mf21/DOMOVOY-Fish-Feeder/README.md

# DOMOVOY-Fish-Feeder
Smart Fish Feeder is a part of DOMOVOY home automation project

https://www.mf21.ru - russian site,

https://www.diyorbuy.tech - english site
