mf21/DOMOVOY-Fish-Feeder/docs/rus/DОМОВОЙ. Монтаж электронной платы.pdf

# ЦЕНТР ТЕХНИЧЕСКИХ РАЗРАБОТОК

## Монтаж электронной платы

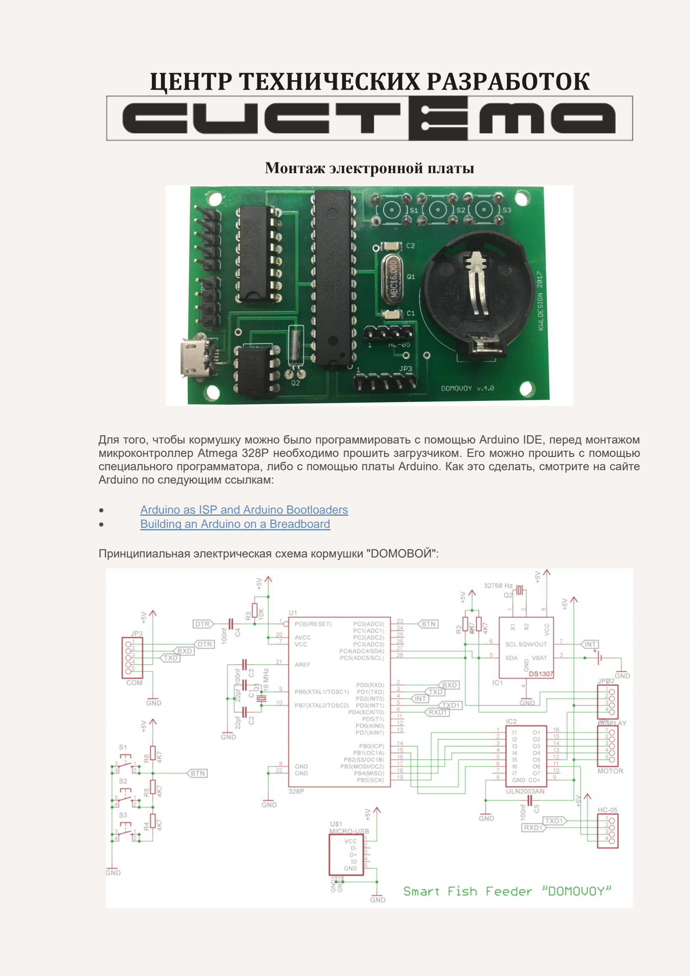
[picture p1: page 1]

Для того, чтобы кормушку можно было программировать с помощью Arduino IDE, перед монтажом микроконтроллер Atmega 328P необходимо прошить загрузчиком. Его можно прошить с помощью специального программатора, либо с помощью платы Arduino. Как это сделать, смотрите на сайте Arduino по следующим ссылкам:

- Arduino as ISP and Arduino Bootloaders (https://www.arduino.cc/en/Tutorial/ArduinoISP)
- Building an Arduino on a Breadboard (https://www.arduino.cc/en/Main/Standalone)

Принципиальная электрическая схема кормушки "DОМОВОЙ":

Детали, необходимые для сборки платы:

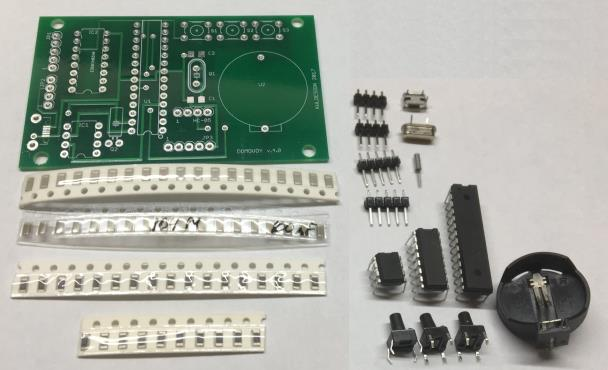
[picture p2: figure]
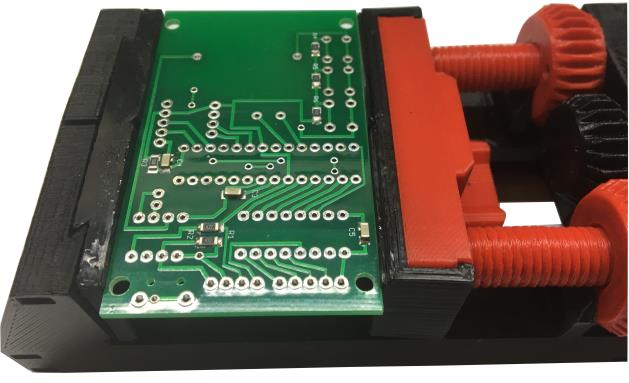
[picture p3: figure]

Подготовьте детали для сборки. | Первыми установите smd компоненты.

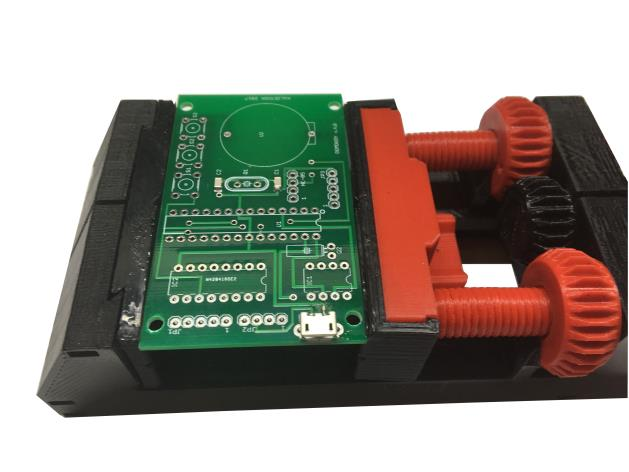
[picture p4: figure]

Установите разъем и конденсаторы на обороте платы.

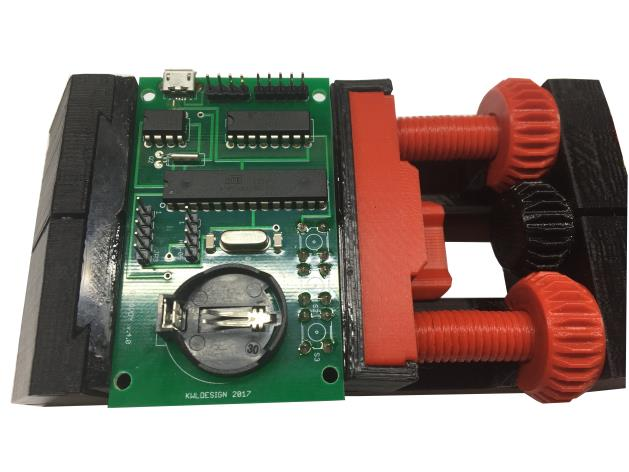
[picture p5: figure]

Установите остальные компоненты.

Наименование | Обозначение на плате | Номинал
Конденсаторы 1206 | C1, C2 | 22 pF
Конденсаторы 1206 | C3, C4, C5 | 100 nF
Резисторы 1206 | R1, R2, R4, R5, R6 | 4K7
Резистор 1206 | R3 | 10 K
Чип RTC | IC1 | DS1307
Драйвер шагового двигателя | IC2 | ULN2003A
Кварцевый резонатор | Q1 | 16 MHz
Кварцевый резонатор | Q2 | 32768 Hz
Микроконтроллер | U1 | Atmega328P-PU
Держатель батареи | U2 | CR2032 Holder
Коннектор | JP1, JP3 | 5 pin header
Коннектор | JP2, HC-05 | 4 pin heade
Кнопки | S1, S2, S3 | Omron Switch
Коннектор | U$1 | Micro-USB

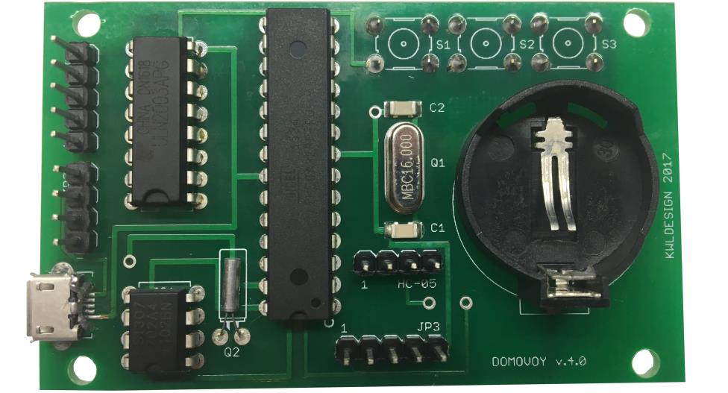
[picture p6: figure]
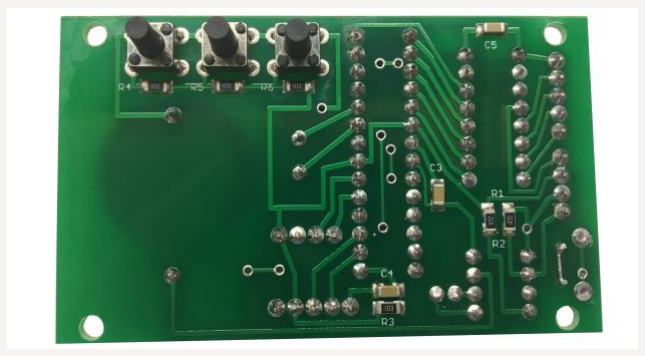
[picture p7: figure]

Вид готовой платы, верхняя сторона. | Вид готовой платы, нижняя сторона.

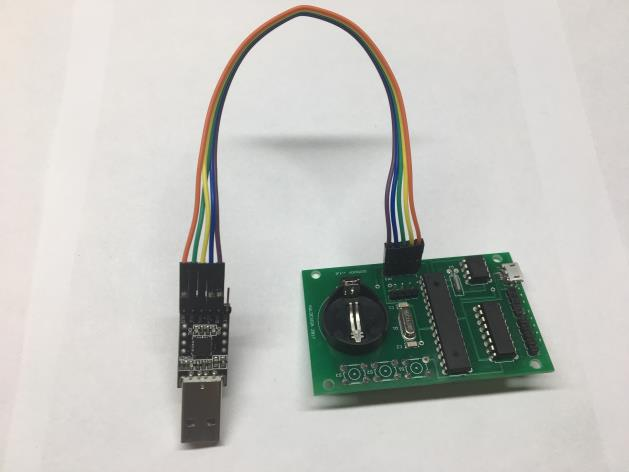
[picture p8: figure]

Используйте программатор USB-UART для прошивки контроллера.

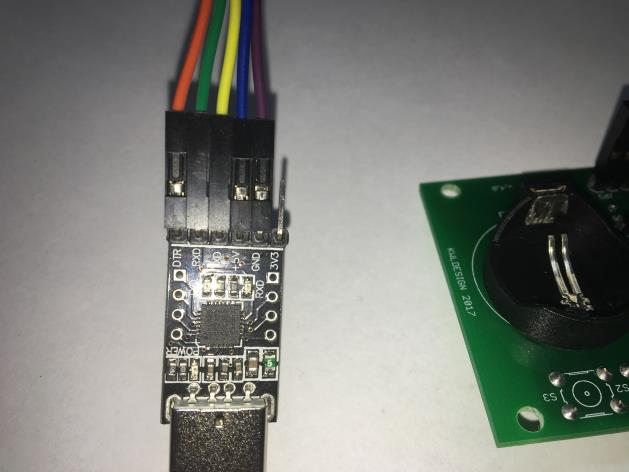
[picture p9: figure]

Схема подключения программатора.
