mf21/DOMOVOY-Fish-Feeder/hardware/hardware.pdf

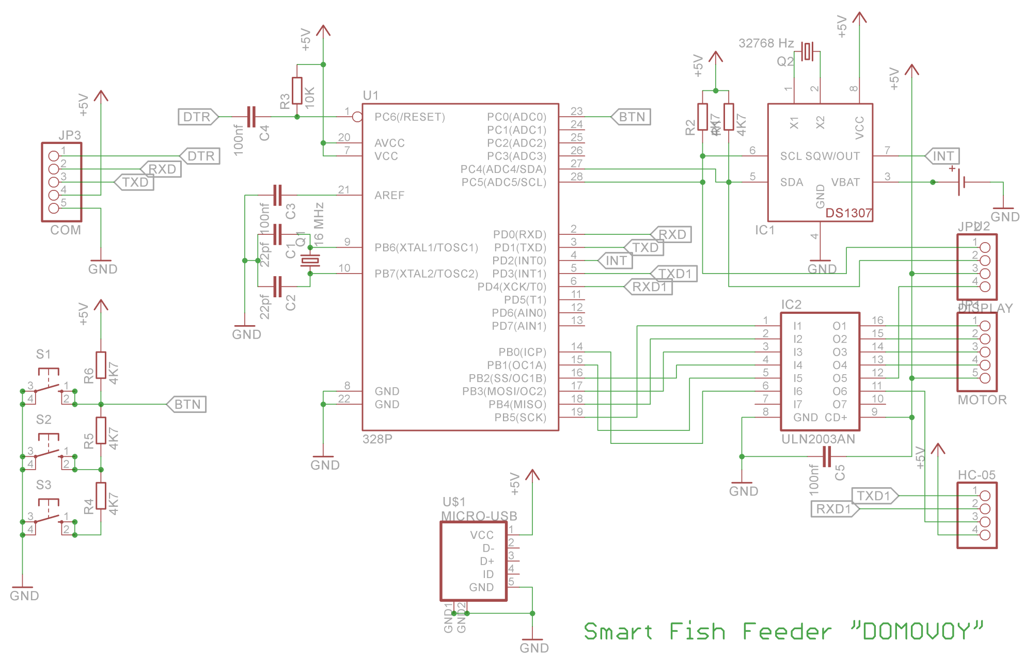
[picture p10: page 1]
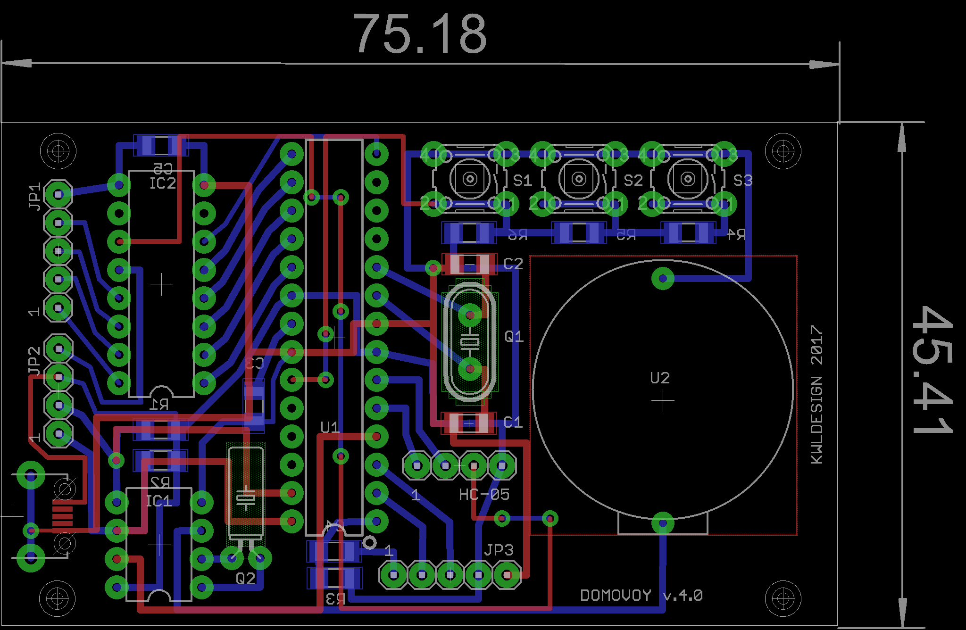
[picture p11: page 2]
