mf21/DOMOVOY-Fish-Feeder/docs/rus/DОМОВОЙ. Примечание к конструктору.pdf

центр технических разработок

### Автоматическая кормушка для аквариумных рыб «DОМОВОЙ»

### Примечание к конструктору

Уважаемый покупатель!

Руководство по сборке кормушки Вы сможете найти на нашем сайте:

https://www.mf21.ru/avtomaticheskaya-kormushka-dlya-ryb

в разделе «Инструкции»
