mf21/DOMOVOY-Fish-Feeder/docs/rus/DОМОВОЙ. Сборка корпуса.pdf

# ЦЕНТР ТЕХНИЧЕСКИХ РАЗРАБОТОК

# Сборка корпуса

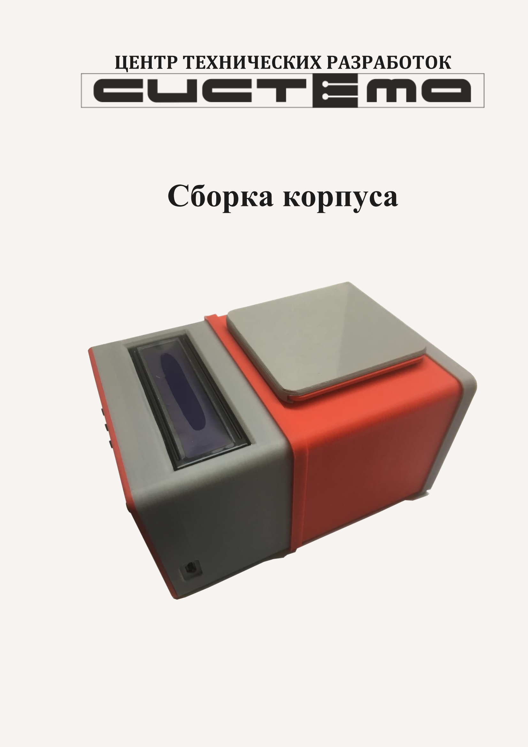
[picture p12: page 1]
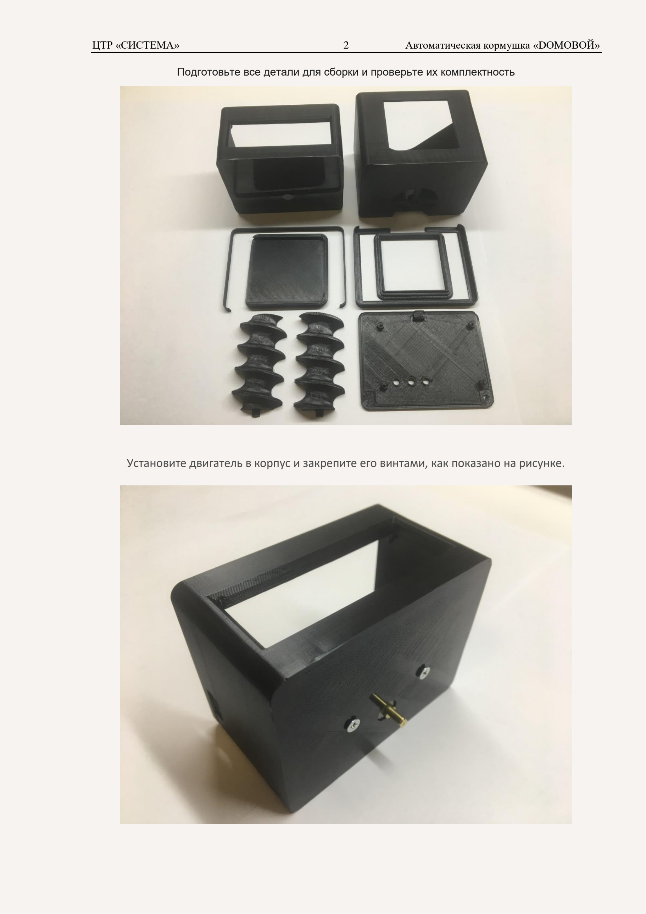
[picture p13: page 2]

ЦТР «СИСТЕМА» | 2 | Автоматическая кормушка «DОМОВОЙ»

Подготовьте все детали для сборки и проверьте их комплектность

Установите двигатель в корпус и закрепите его винтами, как показано на рисунке.

ЦТР «СИСТЕМА» | 3 | Автоматическая кормушка «DОМОВОЙ»

Склейте шнек из двух половинок

Установите шнек внутрь корпуса. Оберните малярным скотчем края половинок корпуса для предотвращения загрязнения поверхностей излишками клея

ЦТР «СИСТЕМА» | 4 | Автоматическая кормушка «DОМОВОЙ»

Аккуратно склейте половинки корпуса.

Оклейте корпус малярным скотчем, как показано на рисунке, для наклейки декоративной рамки.

ЦТР «СИСТЕМА» | 5 | Автоматическая кормушка «DОМОВОЙ»

Приклейте рамку к корпусу кормушки.

Удалите малярный скотч с корпуса кормушки.

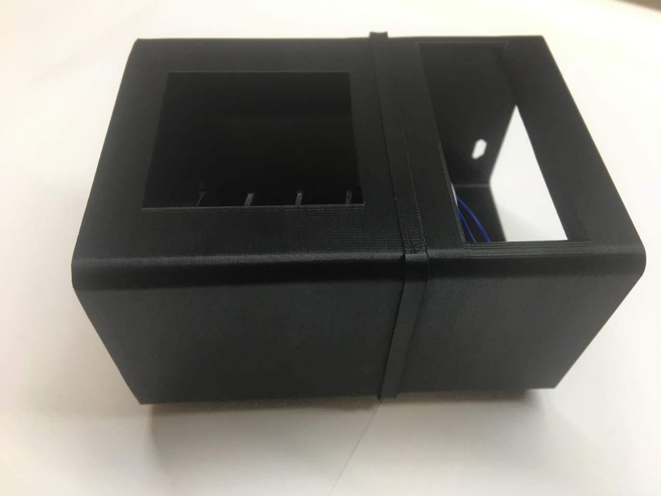
[picture p14: figure]

ЦТР «СИСТЕМА» | 6 | Автоматическая кормушка «DОМОВОЙ»

Аналогичным образом подготовьте переднюю часть корпуса и наклейте вторую декоративную рамку.

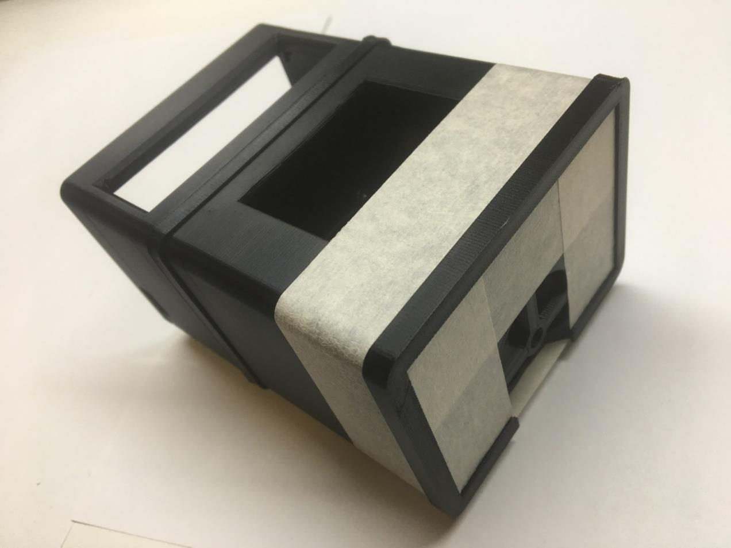
[picture p15: figure]

Удалите скотч после склейки.

ЦТР «СИСТЕМА» | 7 | Автоматическая кормушка «DОМОВОЙ»

Приклейте горловину на верхнюю часть корпуса кормушки.

Установите на горловину крышку, как показано на рисунке.

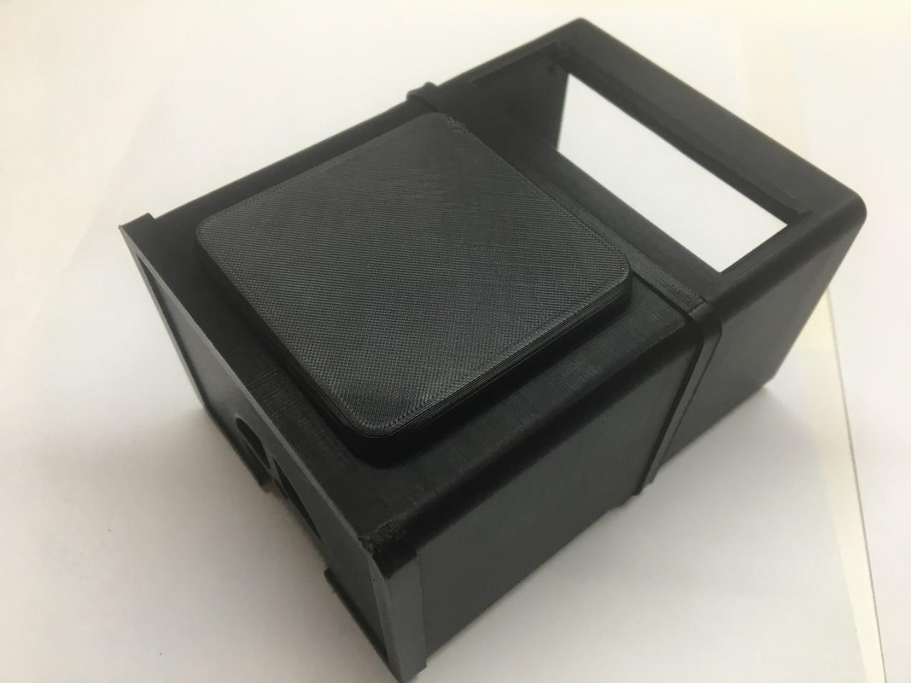
[picture p16: figure]

ЦТР «СИСТЕМА» | 8 | Автоматическая кормушка «DОМОВОЙ»

Отогните штырьки разъема дисплея вертикально вверх, как показано на рисунке.

Установите дисплей внутрь корпуса, зафиксируйте направляющие корпуса в крепежных отверстиях дисплея.

ЦТР «СИСТЕМА» | 9 | Автоматическая кормушка «DОМОВОЙ»

Подготовьте клеевой пистолет. Установите Bluetooth модуль в отведенное место на корпусе кормушки.

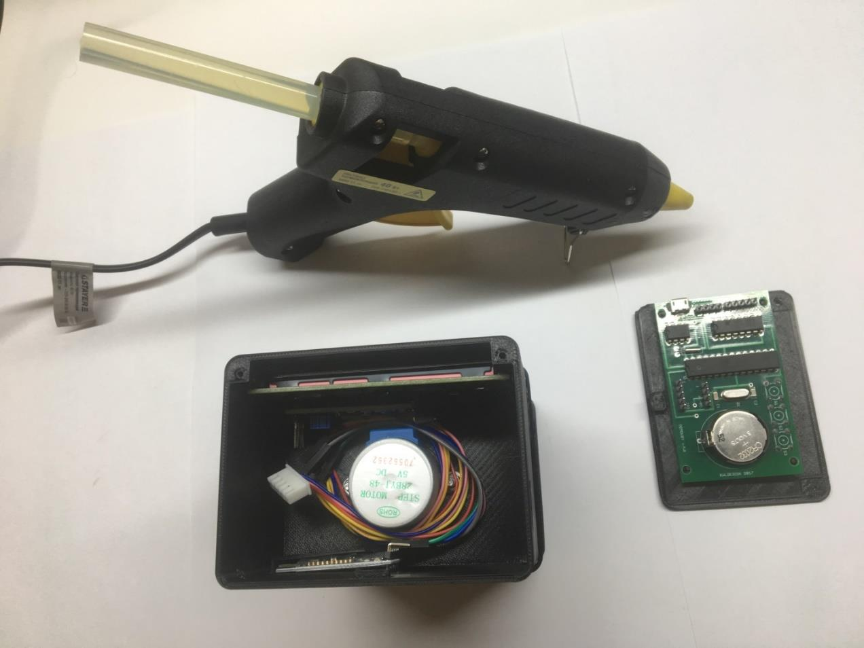
[picture p17: figure]

На заднюю крышку корпуса установите собранную плату.

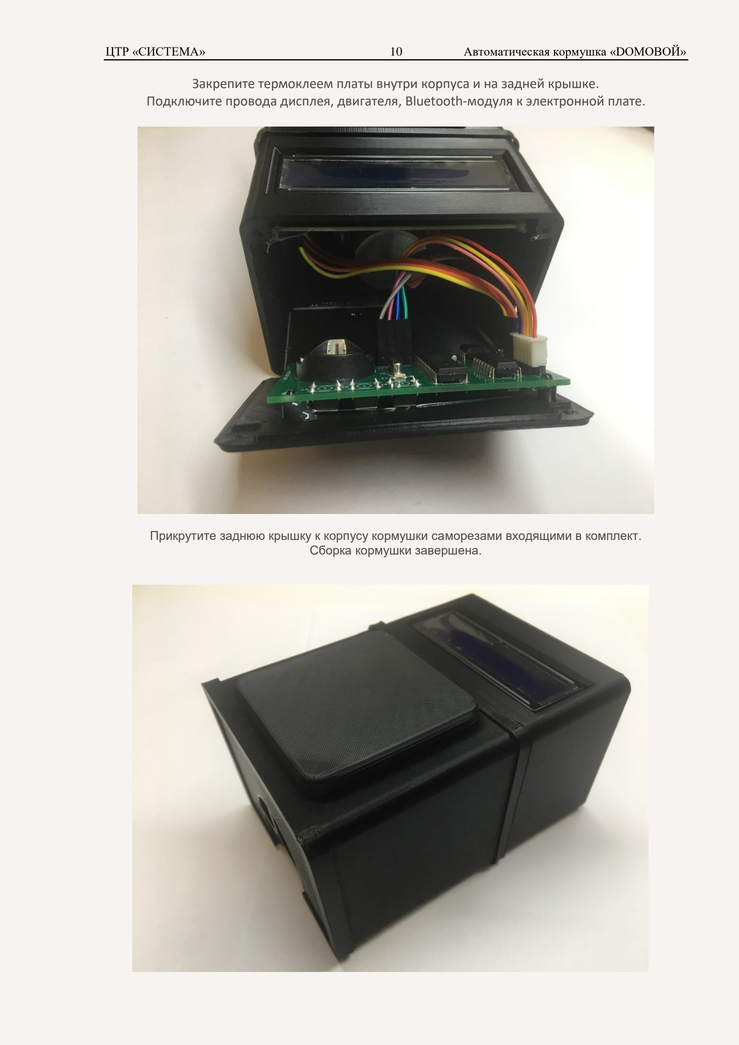
[picture p18: page 10]

ЦТР «СИСТЕМА» | 10 | Автоматическая кормушка «DОМОВОЙ»

Закрепите термоклеем платы внутри корпуса и на задней крышке. Подключите провода дисплея, двигателя, Bluetooth-модуля к электронной плате.

Прикрутите заднюю крышку к корпусу кормушки саморезами входящими в комплект. Сборка кормушки завершена.
