mf21/DOMOVOY-Fish-Feeder/docs/rus/DОМОВОЙ. Руководство по эксплуатации.pdf

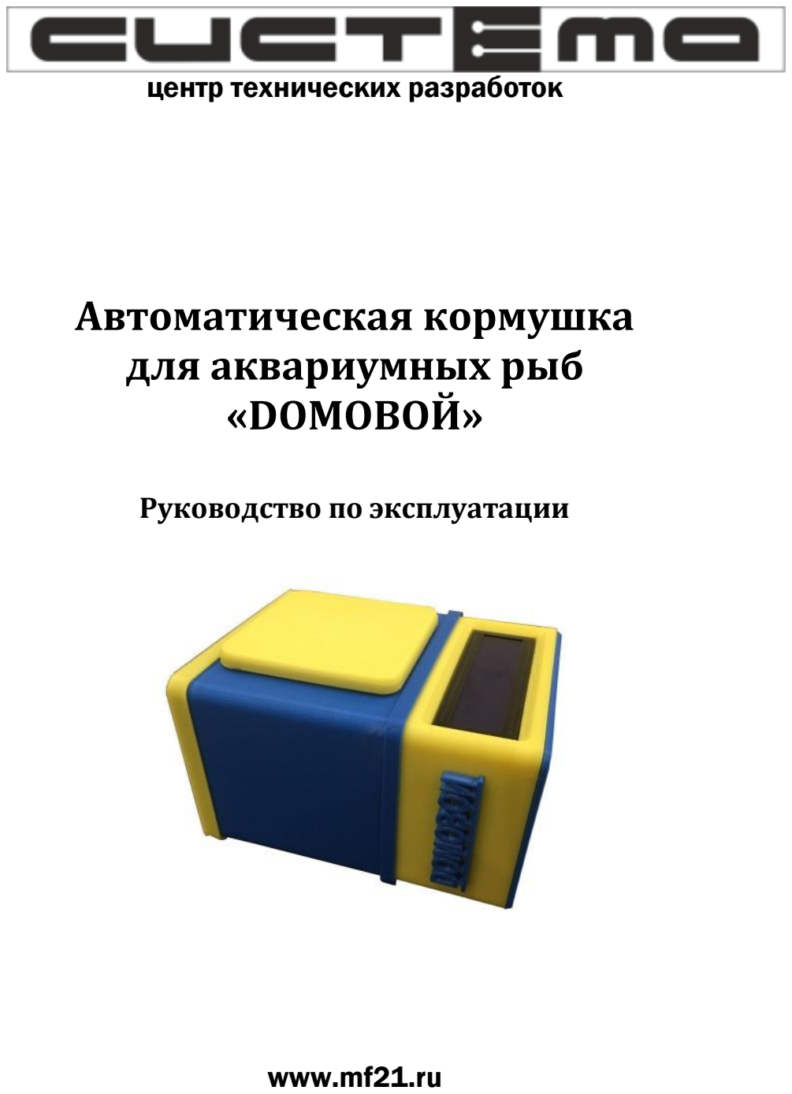
[picture p19: page 1]

центр технических разработок

# Автоматическая кормушка для аквариумных рыб «DОМОВОЙ»

### Руководство по эксплуатации

www.mf21.ru

Введение
Благодарим Вас за выбор нашей автокормушки. Мы постоянно занимаемся совершенствованием наших продуктов и надеемся, что они принесут Вам пользу и оправдают Ваши ожидания.

Комплектация
В коробке Вы найдете:
1. Кормушку DОМОВОЙ.
2. Крышку для отсека с кормом (установлена на кормушку).
3. Кабель питания.
4. Блок питания 5В.

Подготовка к эксплуатации
Подготовьте место установки на Вашем аквариуме. При необходимости проделайте в крышке аквариума необходимое отверстие. Место установки должно иметь достаточную плоскость для установки кормушки. Не допускается свисание над водой части корпуса кормушки более 1 см. Не допускается установка кормушки на искривленные поверхности.

Поместите кормушку на аквариум и убедитесь в ее стабильном положении. Подключите кабель питания сначала к кормушке, затем к блоку питания. Включите блок питания в розетку. Экран кормушки должен засветиться синим светом и на нем должна появиться надпись «Я DОМОВОЙ!» и табло времени.

Загрузка корма
Сдвиньте крышку отсека с кормом в сторону. Засыпьте корм в кормушку. Сдвиньте крышку обратно до упора.

Элементы управления
Кормушка имеет три кнопки расположенные вертикально. Верхняя кнопка отвечает за выбор режимов программирования. Средняя кнопка изменяет часы при установке времени. Нижняя кнопка устанавливает минуты. При последовательном нажатии на одну и ту же кнопку выдерживайте паузу величиной в 1 секунду.

Установка часов
Для установки времени, нажмите два раза на верхнюю кнопку. Первое нажатие включит дисплей и отобразит начальный экран системы, второе – переведет кормушку в режим установки времени. Нажимайте или удерживайте среднюю кнопку до тех пор, пока на экране не установится нужное значение часов. Нажимайте и удерживайте нижнюю кнопку для установки минут. После установки времени нажмите верхнюю кнопку 6 раз для возврата на начальный экран.

Установки времени сохраняются до тех пор, пока кормушка подключена к питанию. При отключении питания часы сбрасываются.

Установка времени кормления
В кормушке можно запрограммировать до четырех кормлений в день. Кормление активируется, если для него установлено время отличное от 00:00. Установка кормления в 00:00 отключает его.

Для того, чтобы установить время 1-го кормления, нажмите верхнюю кнопку 3 раза. Установите час кормления средней кнопкой, минуты – нижней. Нажмите 5 раз на верхнюю кнопку для возврата на начальный экран.

Остальные периоды кормления устанавливаются аналогично. Нажимая верхнюю кнопку, Вы можете переходить от одного кормления к другому.

Установка дозировки подачи корма
Нажмите 7 раз на верхнюю кнопку для перехода в режим установки дозировки кормления. Для установки правильной дозировки мы рекомендуем Вам установить начальное значение 10 единиц и провести ручное кормление (будет описано ниже) для определения объема корма высыпаемого кормушкой. После этого установите значение дозировки пропорционально требуемому объему корма.

Ручное кормление
В любой момент Вы можете вручную инициировать режим кормления. Для этого необходимо одновременно кратковременно нажать среднюю и нижнюю кнопки. Кормушка выполнит ручное кормление.

Важные замечания
Кормушка предназначена для кормления сухим сыпучим кормом. Перед началом эксплуатации убедитесь, что размер гранул корма позволяет им беспрепятственно перемещаться при вращении шнека и проходить через отверстие отсека с кормом.

При кормлении шнек кормушки сначала вращается в обратную сторону на несколько оборотов, затем вращается, подавая корм в аквариум. В конце кормления шнек опять делает несколько оборотов назад. Такой алгоритм вращения шнека позволяет избежать застревания и намокания корма.

При отключении питания текущее время не сохраняется. При повторном включении кормушки Вам потребуется установить его заново. Режимы кормления и дозировка корма сохраняется при отключении питания.

Для очистки кормушки от корма пользуйтесь кисточкой. Не допускается промывание кормушки под водой.

Меры предосторожности
Помните, что блок питания подключен к электрической сети напряжением 220В. Это напряжение опасно для жизни! Сама кормушка питается от напряжения 5В.

Не допускайте возможности падения кормушку в воду.

Не трогайте мокрыми руками блок питания.

При отключении кормушки сначала выньте блок питания из розетки, затем отключите кабель питания от кормушки.

Гарантийные обязательства
Гарантийный срок эксплуатации – 1 год с момента приобретения. Гарантия сохраняется при соблюдении правил эксплуатации использования изделия по назначению.

Контакты
По всем вопросам, связанным с эксплуатацией кормушки Вы можете обращаться:
- по электронной почте: z@mf21.ru;
- по телефонам: +7 (3537) 33-96-79, 308-395.

Центр технических разработок «СИСТЕМА»
462401, Оренбургская область, г. Орск, ул. Строителей, 28Б www.mf21.ru
https://vk.com/homovoy

Дата продажи ________________ Ответственный _____________________
