mf21/DOMOVOY-Fish-Feeder/stl/neck.stl

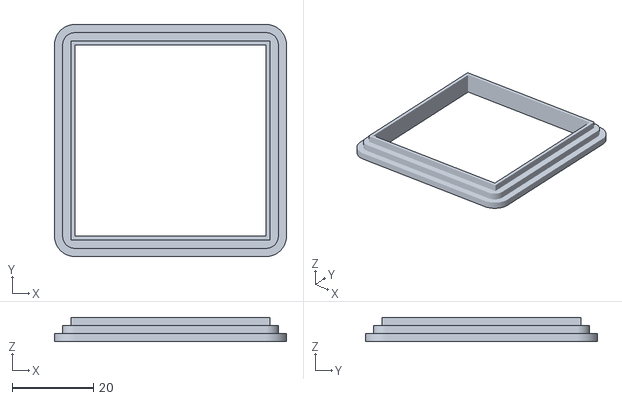
[picture p20: CAD file, 2018-02-25]
stl/neck.stl
57.0 x 57.0 x 6.00
