mf21/DOMOVOY-Fish-Feeder/stl/over-back.stl

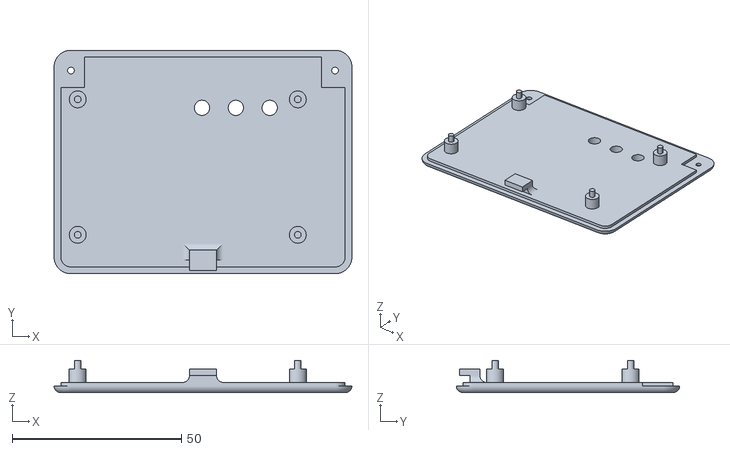
[picture p21: CAD file, 2018-02-25]
stl/over-back.stl
88.0 x 66.0 x 9.50
