mf21/DOMOVOY-Fish-Feeder/stl/case-front.stl

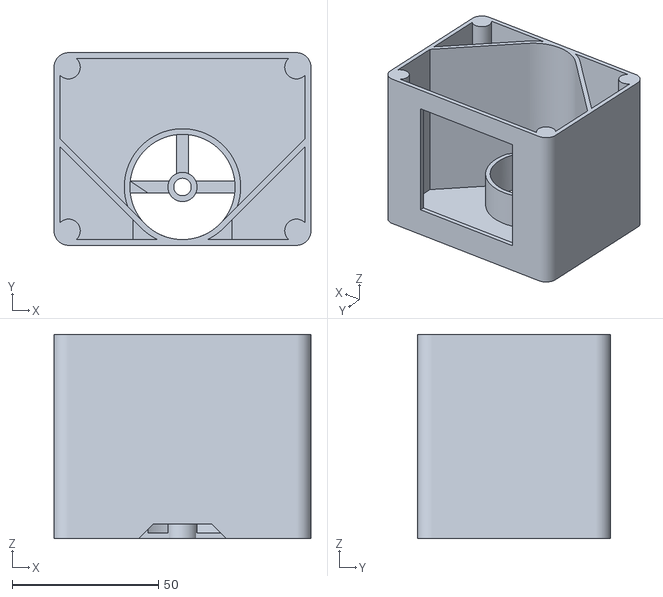
[picture p22: CAD file, 2018-02-25]
stl/case-front.stl
88.0 x 66.0 x 70.0
