mf21/DOMOVOY-Fish-Feeder/stl/auger-top.stl

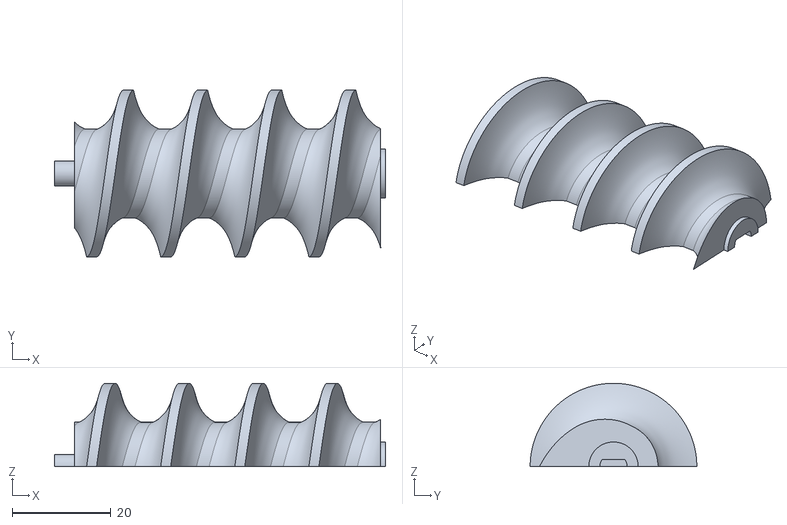
[picture p23: CAD file, 2018-02-25]
stl/auger-top.stl
67.0 x 33.7 x 16.9
