mf21/DOMOVOY-Fish-Feeder/stl/cover-top.stl

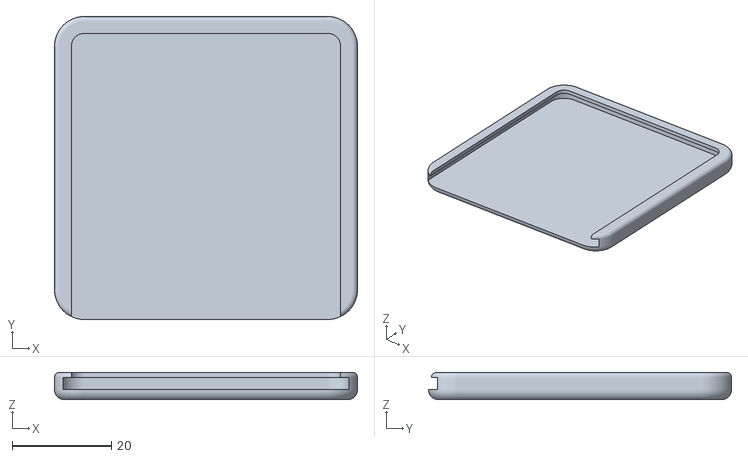
[picture p24: CAD file, 2018-02-25]
stl/cover-top.stl
61.0 x 61.0 x 5.50
