mf21/DOMOVOY-Fish-Feeder/stl/auger-bottom.stl

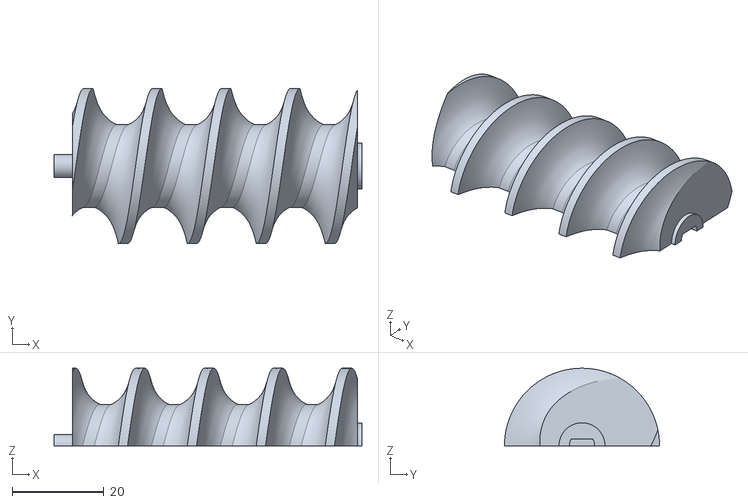
[picture p25: CAD file, 2018-02-25]
stl/auger-bottom.stl
67.0 x 33.7 x 16.9
