mf21/DOMOVOY-Fish-Feeder/stl/edging-front.stl

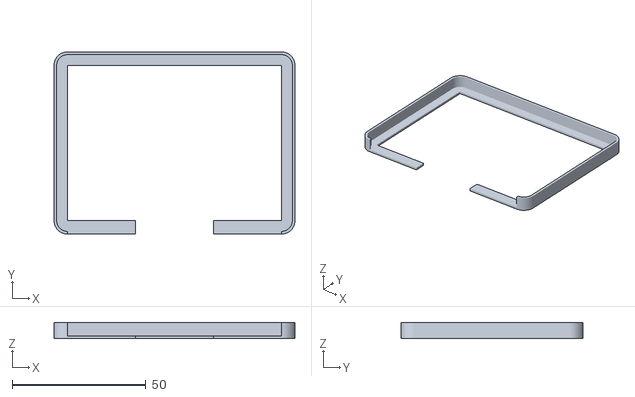
[picture p26: CAD file, 2018-02-25]
stl/edging-front.stl
90.0 x 68.0 x 6.00
