mf21/DOMOVOY-Fish-Feeder/stl/case-back.stl

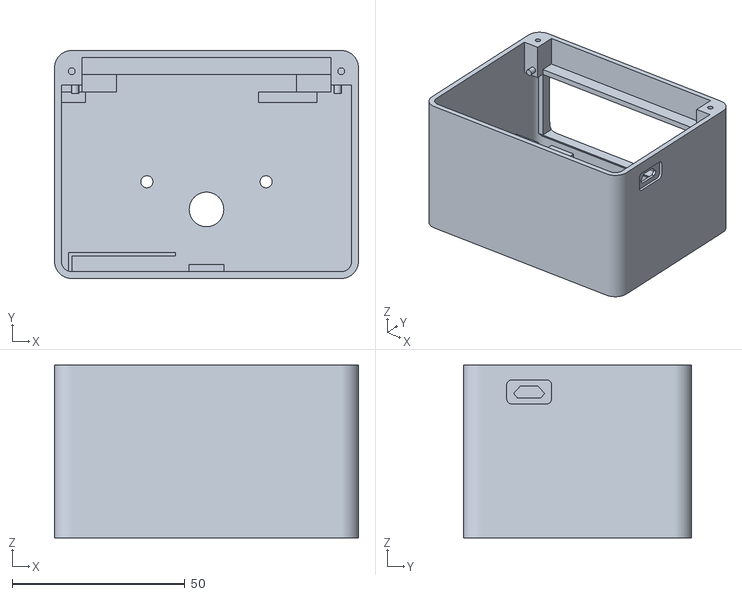
[picture p27: CAD file, 2018-02-25]
stl/case-back.stl
88.0 x 66.0 x 50.0
