mf21/DOMOVOY-Fish-Feeder/stl/edging-back.stl

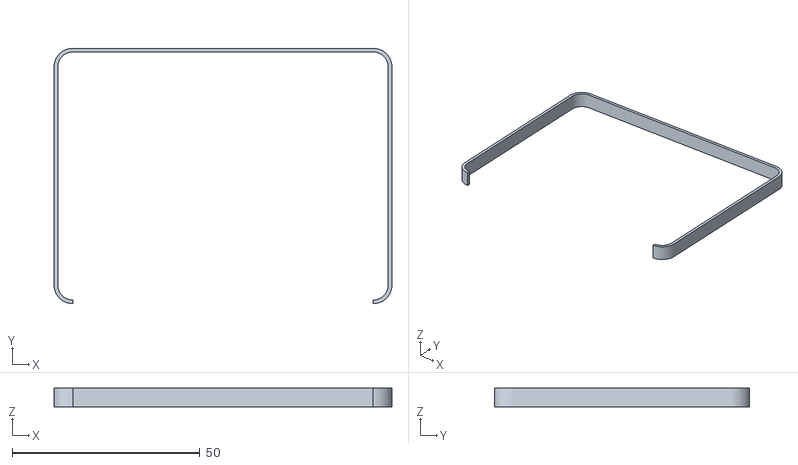
[picture p28: CAD file, 2018-02-25]
stl/edging-back.stl
90.0 x 68.0 x 5.00
