mf21/DOMOVOY-Fish-Feeder/hardware/domovoy-ff1.brd

## EAGLE design hardware/domovoy-ff1.brd (2018-02-25)

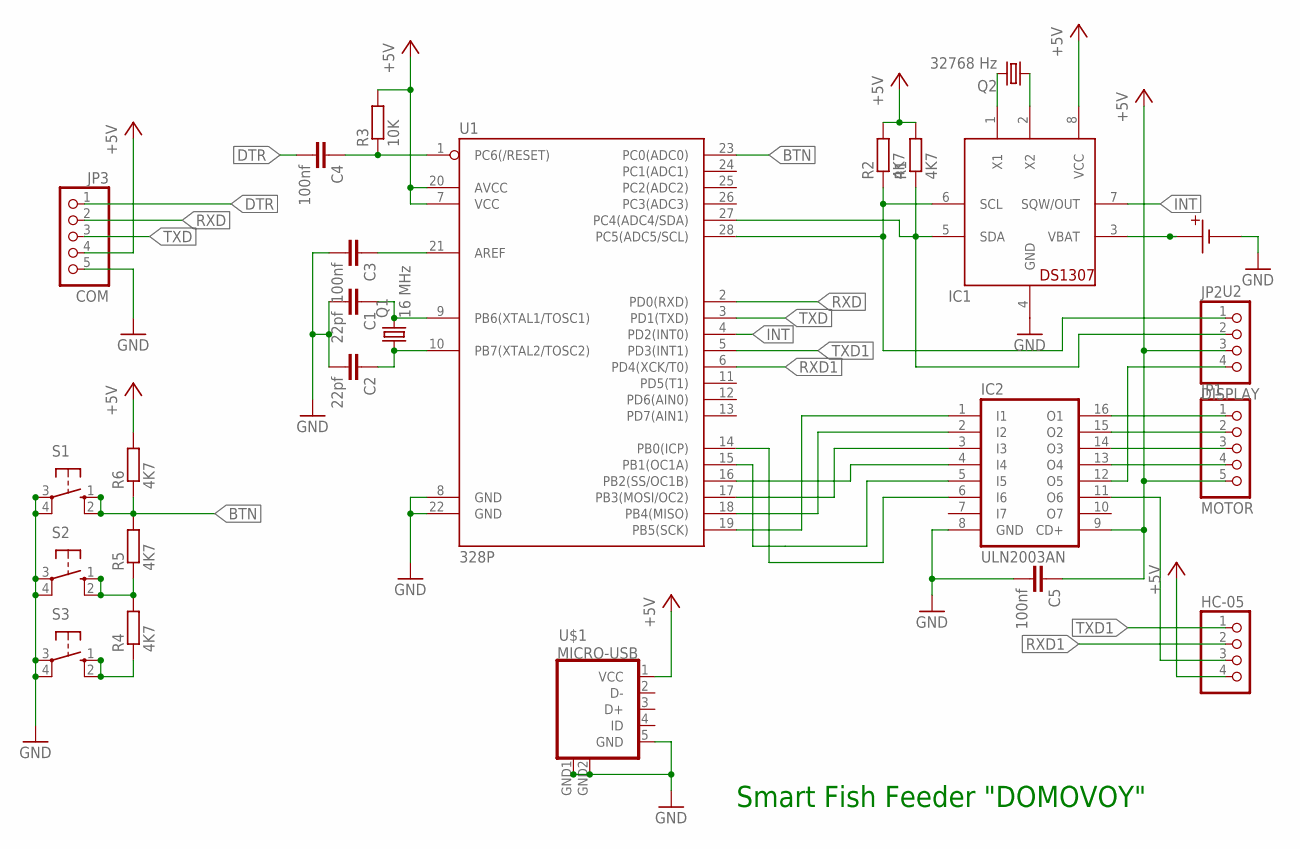
[picture p41: schematic domovoy-ff1.sch]

Parts:
C1, C2: 22pf; C1206
C3, C4, C5: 100nf; C1206
HC-05: PINHD-1X4; 1X04
IC1: DS1307; DIL08
IC2: ULN2003AN; DIL16
JP1: MOTOR; 1X05
JP2: DISPLAY; 1X04
JP3: COM; 1X05
Q1: 16 MHz; HC49/S
Q2: 32768 Hz; TC38H
R1, R2, R4, R5, R6: 4K7; R1206
R3: 10K; R1206
S1, S2, S3: 10-XX; B3F-10XX
U1: 328P; DIP28
U2: CR2032-HOLDERSTANDARD; DIP
U$1: MICRO-USB

Connections:
+5V: C5.1, HC-05.4, IC1.8 (VCC), IC2.9 (CD+), JP1.5, JP2.3, JP3.4, R1.2, R2.2, R3.2, R6.2, U1.7 (VCC), U1.20 (AVCC), U$1.1 (VCC)
BTN: R5.2, R6.1, S1.1 (S), S1.2 (S1), U1.23 (PC0(ADC0))
DTR: C4.2, JP3.1
GND: C1.2, C2.2, C3.2, C5.2, IC1.4 (GND), IC2.8 (GND), JP3.5, S1.3, S1.4 (P1), S2.3, S2.4 (P1), S3.3, S3.4 (P1), U1.8 (GND), U1.22 (GND), U2.GND, U$1.5 (GND), U$1.GND1 (GND), U$1.GND2 (GND)
INT: IC1.7 (SQW/OUT), U1.4 (PD2(INT0))
unnamed: C1.1, Q1.2, U1.9 (PB6(XTAL1/TOSC1))
unnamed: C2.1, Q1.1, U1.10 (PB7(XTAL2/TOSC2))
unnamed: IC2.1 (I1), U1.19 (PB5(SCK))
unnamed: IC2.2 (I2), U1.18 (PB4(MISO))
unnamed: IC2.3 (I3), U1.17 (PB3(MOSI/OC2))
unnamed: IC2.4 (I4), U1.16 (PB2(SS/OC1B))
unnamed: C4.1, R3.1, U1.1 (PC6(/RESET))
unnamed: IC1.1 (X1), Q2.2
unnamed: IC1.2 (X2), Q2.1
unnamed: IC1.6 (SCL), JP2.1, R2.1, U1.28 (PC5(ADC5/SCL))
unnamed: IC1.5 (SDA), JP2.2, R1.1, U1.27 (PC4(ADC4/SDA))
unnamed: C3.1, U1.21 (AREF)
unnamed: IC2.16 (O1), JP1.1
unnamed: IC2.15 (O2), JP1.2
unnamed: IC2.14 (O3), JP1.3
unnamed: IC2.13 (O4), JP1.4
unnamed: IC1.3 (VBAT), U2.POWER
unnamed: IC2.12 (O5), JP2.4
unnamed: R4.2, R5.1, S2.1 (S), S2.2 (S1)
unnamed: R4.1, S3.1 (S), S3.2 (S1)
unnamed: IC2.5 (I5), U1.15 (PB1(OC1A))
unnamed: HC-05.3, IC2.11 (O6)
unnamed: IC2.6 (I6), U1.14 (PB0(ICP))
RXD: JP3.2, U1.2 (PD0(RXD))
RXD1: HC-05.2, U1.6 (PD4(XCK/T0))
TXD: JP3.3, U1.3 (PD1(TXD))
TXD1: HC-05.1, U1.5 (PD3(INT1))

Notes on the sheet:
Smart Fish Feeder "DOMOVOY"

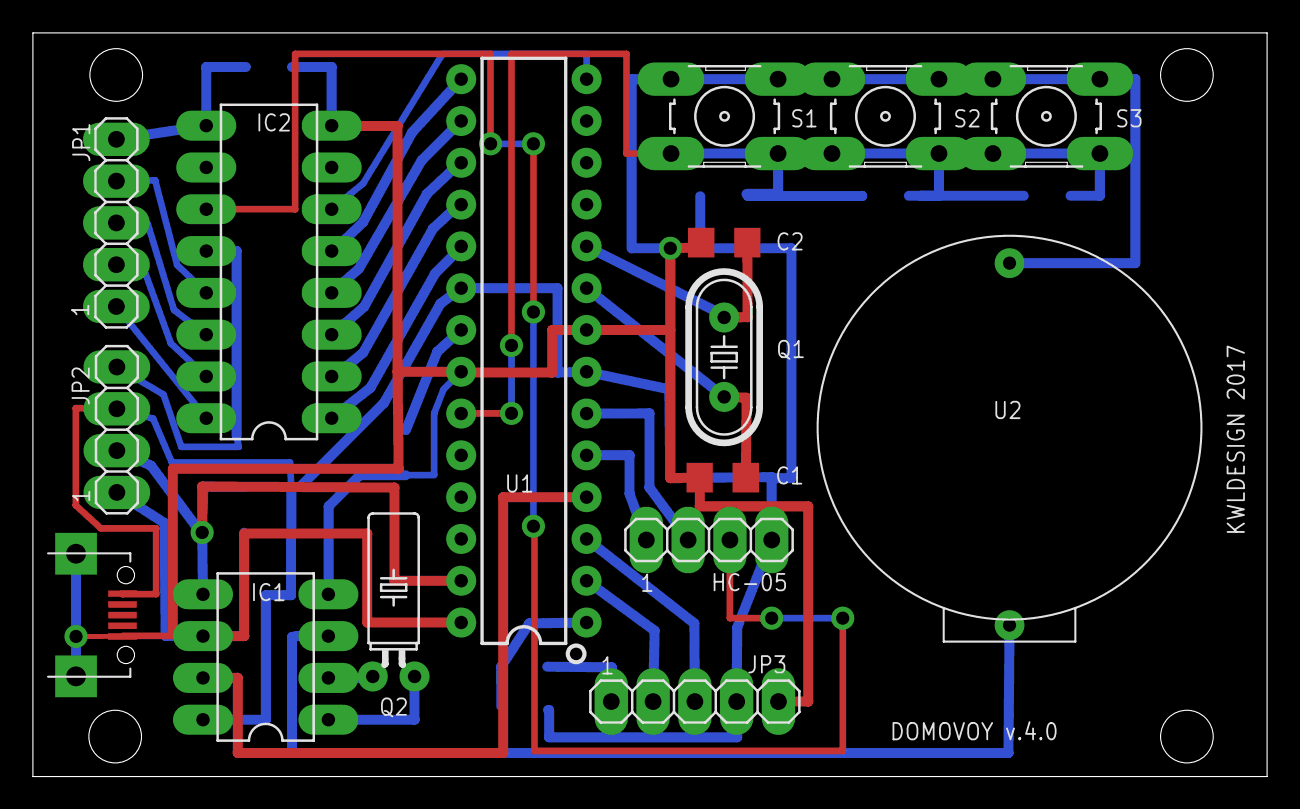
[picture p42: board domovoy-ff1.brd from above]

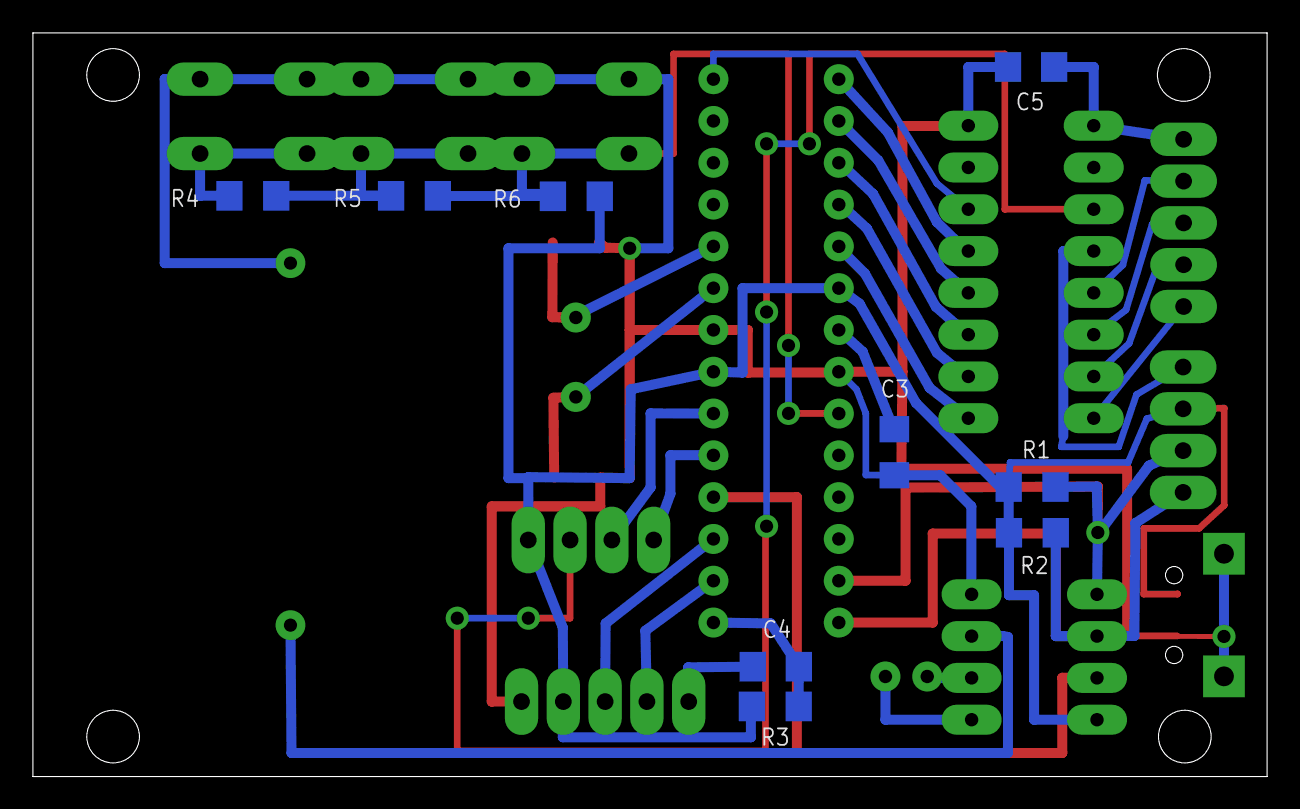
[picture p43: board domovoy-ff1.brd from below]

Board: 2 copper layers, 75.0 x 45.2 mm, 25 parts (9 on the bottom side), 32 nets.
