mf21/DOMOVOY-Fish-Feeder/(commit log)

2018-04-03 Instruction of assembly PCB board added
2018-04-14 PCB assembly document added
2018-04-23 Update firmware.ino
    Traslation bug fixed
    [firmware.ino]
